bitgamma/gradusnik/(list of files, drawings)

Other design files:
gradusnik.dch
gradusnik.dip
