bitgamma/gradusnik/main.c

/*
 * Copyright (C) 2014, Michele Balistreri
 * 
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
 * THE SOFTWARE IS PROVIDED "AS IS", WITHOUT WARRANTY OF ANY KIND, EXPRESS OR
 * IMPLIED, INCLUDING BUT NOT LIMITED TO THE WARRANTIES OF MERCHANTABILITY,
 * FITNESS FOR A PARTICULAR PURPOSE AND NONINFRINGEMENT.  IN NO EVENT SHALL
 * THE AUTHORS OR COPYRIGHT HOLDERS BE LIABLE FOR ANY CLAIM, DAMAGES OR OTHER
 * LIABILITY, WHETHER IN AN ACTION OF CONTRACT, TORT OR OTHERWISE, ARISING
 * FROM, OUT OF OR IN CONNECTION WITH THE SOFTWARE OR THE USE OR OTHER
 * DEALINGS IN THE SOFTWARE.
 */

#include "config.h"
#include "MRF24J40.h"
#include "osnp.h"
#include "tlv.h"

#include <xc.h>
#include <stdlib.h>

static uint8_t rx_frame_buf[128];

static uint8_t wdt_en;
static uint8_t radio_sleep_en;
static int8_t timer_periods;
static int16_t calibration_offset;

bool transmitting;

#define CALIBRATION_OFFSET_ADDR 14
#define DEVICE_INFO_ADDR 72

__EEPROM_DATA(0x70, 0x3d, 0x62, 0x63, 0x96, 0x2c, 0x9b, 0xf2);
__EEPROM_DATA(0x00, 0x00, 0xff, 0xff, 0xff, 0xff, 0x00, 0x00);
__EEPROM_DATA(0x00, 0x01, 0x02, 0x03, 0x04, 0x05, 0x06, 0x07);
__EEPROM_DATA(0x08, 0x09, 0x0A, 0x0B, 0x0C, 0x0D, 0x0E, 0x0F);
__EEPROM_DATA(0x00, 0x00, 0x00, 0x00, 0x00, 0x00, 0x00, 0x00);
__EEPROM_DATA(0x00, 0x00, 0x00, 0x00, 0x00, 0x00, 0x00, 0x00);
__EEPROM_DATA(0x00, 0x00, 0x00, 0x00, 0x00, 0x00, 0x00, 0x00);
__EEPROM_DATA(0x00, 0x00, 0x00, 0x00, 0x00, 0x00, 0x00, 0x00);
__EEPROM_DATA(0x00, 0x00, 0x00, 0x00, 0x00, 0x00, 0x00, 0x00);
__EEPROM_DATA(0x28, 0xA0, 0x26, 0x81, 0x02, 0x00, 0x01, 0x82);
__EEPROM_DATA(0x01, 0xA2, 0xC0, 0x09, 'G', 'r', 'a', 'd');
__EEPROM_DATA('u', 's', 'n', 'i', 'k', 0xC1, 0x12, 'M');
__EEPROM_DATA('i', 'c', 'h', 'e', 'l', 'e', ' ', 'B');
__EEPROM_DATA('a', 'l', 'i', 's', 't', 'r', 'e', 'r');
__EEPROM_DATA('i', 0xff, 0xff, 0xff, 0xff, 0xff, 0xff, 0xff);

#define load_calibration_offset(buf) load_eeprom(buf, CALIBRATION_OFFSET_ADDR, 2)
#define write_calibration_offset(buf) write_eeprom(buf, CALIBRATION_OFFSET_ADDR, 2)

void load_eeprom(uint8_t *buf, uint16_t addr, uint16_t len) {
  EECON1bits.CFGS = 0;
  EECON1bits.EEPGD = 0;

  for (uint16_t i = 0; i < len; i++) {
    EEADR = addr++;
	EECON1bits.RD = 1;
    buf[i] = EEDATA;
  }
}

void write_eeprom(uint8_t *buf, uint16_t addr, uint16_t len) {
  INTCONbits.GIE = 0;
  EECON1bits.EEPGD = 0;
  EECON1bits.CFGS = 0;

  for (uint16_t i = 0; i < len; i++) {
	EEADR = addr++;
	EEDATA = buf[i];
	EECON1bits.WREN = 1;
    EECON2 = 0x55;
    EECON2 = 0xAA;
	EECON1bits.WR = 1;
	while(EECON1bits.WR);
	EECON1bits.WREN = 0;
  }

  INTCONbits.GIE = 1;
}

uint8_t spi_read() {
  uint8_t tmp;
  tmp = SSP1BUF;
  PIR1bits.SSP1IF = 0;
  SSP1BUF = 0x00;
  while(!PIR1bits.SSP1IF);
  return SSP1BUF;
}

void spi_write(uint8_t data) {
  uint8_t tmp;
  tmp = SSP1BUF;
  PIR1bits.SSP1IF = 0;
  SSP1BUF = data;
  while( !PIR1bits.SSP1IF );
}

void enable_wdt(uint8_t periods, bool radio_can_sleep) {
  wdt_en = true;
  radio_sleep_en = radio_can_sleep;
  timer_periods = periods;
}

void disable_wdt(void) {
  wdt_en = false;
  radio_sleep_en = false;
}

uint16_t process_get_device_info(uint8_t *buf) {
  uint8_t addr = DEVICE_INFO_ADDR;

  EEADR = addr++;
  EECON1 = 0x01;
  uint16_t len = EEDATA;

  load_eeprom(buf, addr, len);

  return len;
}

void write_temperature(uint8_t *buf) {
  LATAbits.LA0 = 1;
  VREFCON0 = 0x90;
  ADCON0bits.ADON = 1;

  __delay_ms(1);

  ADCON0bits.GO = 1;
  while(ADCON0bits.GO);
  
  uint16_t adc = (((uint16_t) ADRESH) << 8) | (ADRESL);

  if (adc >= 1023) {
    VREFCON0 = 0xA0;
    ADCON0bits.GO = 1;
    while(ADCON0bits.GO);
    adc = (((uint16_t) ADRESH) << 8) | (ADRESL);
    adc = (adc << 1);
  }

  LATAbits.LA0 = 0;
  ADCON0bits.ADON = 0;
  VREFCON0 = 0;

  // 500mV is our 0 point
  adc -= 500;
  adc += calibration_offset;
  
  *buf++ = ((uint16_t) adc) >> 8;
  *buf++ = adc & 0xff;
};

uint16_t process_get_data(uint8_t *buf) {
  *buf++ = 0xA2;
  *buf++ = 0x0C;
  *buf++ = 0xA1;
  *buf++ = 0x0A;
  *buf++ = 0x80;
  *buf++ = 0x01;
  *buf++ = 0x01;
  *buf++ = 0x81;
  *buf++ = 0x01;
  *buf++ = 0x0A;
  *buf++ = 0x82;
  *buf++ = 0x02;
  write_temperature(buf);
  buf += 2;

  return 14;
}

uint16_t process_configure(uint8_t *in_buf) {
  //TODO: crude, but should work
  if (in_buf[3] == 0x82) {
    calibration_offset = (in_buf[4] << 8) | in_buf[5];
    write_calibration_offset((uint8_t *)&calibration_offset);
  }

  return 0;
}

void write_error(uint8_t tag, uint8_t err, ieee802_15_4_frame_t *resp_frame, uint16_t *resp_off) {
  *resp_off += tlv_write_tag(&resp_frame->payload[*resp_off], tag);
  *resp_off += tlv_write_length(&resp_frame->payload[*resp_off], 3);
  *resp_off += tlv_write_tag(&resp_frame->payload[*resp_off], 0x9E);
  *resp_off += tlv_write_length(&resp_frame->payload[*resp_off], 1);
  resp_frame->payload[*resp_off++] = err;
}

void process_command(ieee802_15_4_frame_t *frame, uint16_t *in_off, ieee802_15_4_frame_t *resp_frame, uint16_t *resp_off, uint8_t associated) {
  uint16_t tag;
  uint16_t len;

  *in_off += tlv_read_tag(&frame->payload[*in_off], &tag);
  *in_off += tlv_read_length(&frame->payload[*in_off], &len);
  *in_off += len;

  switch(tag) {
    case OSNP_GET_DEVICE_INFO:
      *resp_off += process_get_device_info(&resp_frame->payload[*resp_off]);
      break;
    case OSNP_GET_DATA:
      if (!associated) {
        write_error(tag, OSNP_SECURITY_ERROR, resp_frame, resp_off);
      } else {
        *resp_off += process_get_data(&resp_frame->payload[*resp_off]);
      }
      break;
    case OSNP_CONFIGURE:
      if (!associated) {
        write_error(tag, OSNP_SECURITY_ERROR, resp_frame, resp_off);
      } else {
        process_configure(&frame->payload[*in_off]);
      }
      break;
    default:
      write_error(tag, OSNP_UNSUPPORTED_COMMAND, resp_frame, resp_off);
      break;
  }
}

void interrupt isr(void) {
  if (INTCON3bits.INT1F) {
    INTCON3bits.INT1F = 0;
    int interrupts = mrf24j40_int_tasks();
    
    if (interrupts & MRF24J40_INT_RX) {
      if (!mrf24j40_rx_sec_fail()) {
        osnp_frame_received_cb(rx_frame_buf, mrf24j40_rxpkt_intcb(rx_frame_buf, NULL, NULL));
      } else {
        mrf24j40_rxfifo_flush();
      }
    }

    if (interrupts & MRF24J40_INT_TX) {
      transmitting = false;
      osnp_frame_sent_cb(mrf24j40_txpkt_intcb());
    }

    if (interrupts & MRF24J40_INT_SEC) {
      mrf24j40_sec_intcb(true);
    }
  }
}

void main(void) {
  OSCCON2bits.MFIOSEL = 1;
  OSCCONbits.IRCF = 0x02;
  
  INTCONbits.GIE = 0;
  RCONbits.IPEN = 0;
  INTCON3bits.INT1E = 1;
  INTCON2bits.INTEDG1 = 0;
  
  TRISA = 0x20;
  TRISB = 0x02;
  TRISC = 0x10;

  LATA = 0;
  LATB = 0;
  LATC = 0;

  WPUB = 0;
  
  ADCON0 = 0x10;
  ADCON1 = 0x08;
  ADCON2 = 0xAF;

  ANSELA = 0x20;
  ANSELB = 0x00;
  ANSELC = 0x00;

  SSP1STATbits.CKE = 1;
  SSP1CON1 = 0x20;

  load_calibration_offset((uint8_t *)&calibration_offset);
  mrf24j40_initialize();
  mrf24j40_set_cipher(OSNP_SECURITY_LEVEL, OSNP_SECURITY_LEVEL);
  osnp_initialize();
  
  INTCON3bits.INT1F = 0;
  INTCONbits.GIE = 1;

  while(1) {
    uint16_t tx_timeout = 500;
    while(transmitting && tx_timeout) {
      __delay_ms(1);
      tx_timeout--;
    }

    // the transceiver skipped an interrupt
    if (transmitting) {
      transmitting = false;
      mrf24j40_read_short_ctrl_reg(INTSTAT);
      osnp_frame_sent_cb(mrf24j40_txpkt_intcb());
    }

    if (radio_sleep_en) {
      INTCONbits.GIE = 0;
      mrf24j40_sleep();
    }

    if (wdt_en) {
      WDTCONbits.SWDTEN = 1;
    }

    SLEEP();
    WDTCONbits.SWDTEN = 0;

    if (!RCONbits.TO) {
      timer_periods--;

      if (timer_periods <= 0) {
        wdt_en = false;

        if (radio_sleep_en) {
          radio_sleep_en = false;
          mrf24j40_wakeup();
          mrf24j40_rxfifo_flush();
          INTCONbits.GIE = 1;
        }
        
        osnp_timer_expired_cb();
      }
    }
  }
}
