bitgamma/gradusnik/config.h

/*
 * Copyright (C) 2014, Michele Balistreri
 *
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
 * THE SOFTWARE IS PROVIDED "AS IS", WITHOUT WARRANTY OF ANY KIND, EXPRESS OR
 * IMPLIED, INCLUDING BUT NOT LIMITED TO THE WARRANTIES OF MERCHANTABILITY,
 * FITNESS FOR A PARTICULAR PURPOSE AND NONINFRINGEMENT.  IN NO EVENT SHALL
 * THE AUTHORS OR COPYRIGHT HOLDERS BE LIABLE FOR ANY CLAIM, DAMAGES OR OTHER
 * LIABILITY, WHETHER IN AN ACTION OF CONTRACT, TORT OR OTHERWISE, ARISING
 * FROM, OUT OF OR IN CONNECTION WITH THE SOFTWARE OR THE USE OR OTHER
 * DEALINGS IN THE SOFTWARE.
 */

#ifndef CONFIG_H
#define	CONFIG_H

// PIC18F14K50 Configuration Bit Settings
#define _XTAL_FREQ 500000


// PIC18F26K22 Configuration Bit Settings

// CONFIG1H
#pragma config FOSC = INTIO67   // Oscillator Selection bits (Internal oscillator block)
#pragma config PLLCFG = OFF     // 4X PLL Enable (Oscillator used directly)
#pragma config PRICLKEN = ON    // Primary clock enable bit (Primary clock enabled)
#pragma config FCMEN = OFF      // Fail-Safe Clock Monitor Enable bit (Fail-Safe Clock Monitor disabled)
#pragma config IESO = OFF       // Internal/External Oscillator Switchover bit (Oscillator Switchover mode disabled)

// CONFIG2L
#pragma config PWRTEN = OFF     // Power-up Timer Enable bit (Power up timer disabled)
#pragma config BOREN = OFF      // Brown-out Reset Enable bits (Brown-out Reset disabled in hardware and software)
#pragma config BORV = 190       // Brown Out Reset Voltage bits (VBOR set to 1.90 V nominal)

// CONFIG2H
#pragma config WDTEN = SWON     // Watchdog Timer Enable bits (WDT is controlled by SWDTEN bit of the WDTCON register)
#pragma config WDTPS = 256      // Watchdog Timer Postscale Select bits (1:256)

// CONFIG3H
#pragma config CCP2MX = PORTB3  // CCP2 MUX bit (CCP2 input/output is multiplexed with RB3)
#pragma config PBADEN = OFF     // PORTB A/D Enable bit (PORTB<5:0> pins are configured as digital I/O on Reset)
#pragma config CCP3MX = PORTB5  // P3A/CCP3 Mux bit (P3A/CCP3 input/output is multiplexed with RB5)
#pragma config HFOFST = ON      // HFINTOSC Fast Start-up (HFINTOSC output and ready status are not delayed by the oscillator stable status)
#pragma config T3CMX = PORTB5   // Timer3 Clock input mux bit (T3CKI is on RB5)
#pragma config P2BMX = PORTB5   // ECCP2 B output mux bit (P2B is on RB5)
#pragma config MCLRE = EXTMCLR  // MCLR Pin Enable bit (MCLR pin enabled, RE3 input pin disabled)

// CONFIG4L
#pragma config STVREN = ON      // Stack Full/Underflow Reset Enable bit (Stack full/underflow will cause Reset)
#pragma config LVP = ON         // Single-Supply ICSP Enable bit (Single-Supply ICSP enabled if MCLRE is also 1)
#pragma config XINST = OFF      // Extended Instruction Set Enable bit (Instruction set extension and Indexed Addressing mode disabled (Legacy mode))

// CONFIG5L
#pragma config CP0 = OFF        // Code Protection Block 0 (Block 0 (000800-003FFFh) not code-protected)
#pragma config CP1 = OFF        // Code Protection Block 1 (Block 1 (004000-007FFFh) not code-protected)
#pragma config CP2 = OFF        // Code Protection Block 2 (Block 2 (008000-00BFFFh) not code-protected)
#pragma config CP3 = OFF        // Code Protection Block 3 (Block 3 (00C000-00FFFFh) not code-protected)

// CONFIG5H
#pragma config CPB = OFF        // Boot Block Code Protection bit (Boot block (000000-0007FFh) not code-protected)
#pragma config CPD = OFF        // Data EEPROM Code Protection bit (Data EEPROM not code-protected)

// CONFIG6L
#pragma config WRT0 = OFF       // Write Protection Block 0 (Block 0 (000800-003FFFh) not write-protected)
#pragma config WRT1 = OFF       // Write Protection Block 1 (Block 1 (004000-007FFFh) not write-protected)
#pragma config WRT2 = OFF       // Write Protection Block 2 (Block 2 (008000-00BFFFh) not write-protected)
#pragma config WRT3 = OFF       // Write Protection Block 3 (Block 3 (00C000-00FFFFh) not write-protected)

// CONFIG6H
#pragma config WRTC = OFF       // Configuration Register Write Protection bit (Configuration registers (300000-3000FFh) not write-protected)
#pragma config WRTB = OFF       // Boot Block Write Protection bit (Boot Block (000000-0007FFh) not write-protected)
#pragma config WRTD = OFF       // Data EEPROM Write Protection bit (Data EEPROM not write-protected)

// CONFIG7L
#pragma config EBTR0 = OFF      // Table Read Protection Block 0 (Block 0 (000800-003FFFh) not protected from table reads executed in other blocks)
#pragma config EBTR1 = OFF      // Table Read Protection Block 1 (Block 1 (004000-007FFFh) not protected from table reads executed in other blocks)
#pragma config EBTR2 = OFF      // Table Read Protection Block 2 (Block 2 (008000-00BFFFh) not protected from table reads executed in other blocks)
#pragma config EBTR3 = OFF      // Table Read Protection Block 3 (Block 3 (00C000-00FFFFh) not protected from table reads executed in other blocks)

// CONFIG7H
#pragma config EBTRB = OFF      // Boot Block Table Read Protection bit (Boot Block (000000-0007FFh) not protected from table reads executed in other blocks)


// Includes
#include <xc.h>
#include <stdint.h>
#include <stdbool.h>
#include "MRF24J40.h"
#include "osnp.h"

// Definitions
#define OSNP_FRAME_COUNTER_WINDOW 1000
#define OSNP_SECURITY_LEVEL SL_AES_CCM_64
#define OSNP_MIC_LENGTH 8
#define LITTLE_ENDIAN

#define EUI_64_ADDR 0
#define PAN_ID_ADDR 8
#define SHORT_ADDRESS_ADDR 10
#define CHANNEL_ADDR 12
#define MASTER_KEY 16
#define RX_AES_KEY 32
#define TX_AES_KEY 48
#define RX_FRAME_COUNTER 64
#define TX_FRAME_COUNTER 68

// MRF24J40 HAL Configuration
#define mrf24j40_set_ie(v) (INTCON3bits.INT1E = v)
#define mrf24j40_get_ie() (INTCON3bits.INT1E)

#define mrf24j40_reset_pin(v) (PORTCbits.RC0 = v)
#define mrf24j40_wake_pin(v) (PORTCbits.RC1 = v)
#define mrf24j40_cs_pin(v) (PORTCbits.RC2 = v)

#define mrf24j40_spi_read() spi_read()
#define mrf24j40_spi_write(val) spi_write(val)
#define mrf24j40_delay_us(v) __delay_us(v)
#define mrf24j40_delay_ms(v) __delay_ms(v)

// OSNP HAL Configuration
#define osnp_load_eui(buf) load_eeprom(buf, EUI_64_ADDR, 8); mrf24j40_set_eui(buf)
#define osnp_load_pan_id(buf) load_eeprom(buf, PAN_ID_ADDR, 2); mrf24j40_set_pan(buf)
#define osnp_load_short_address(buf) load_eeprom(buf, SHORT_ADDRESS_ADDR, 2); mrf24j40_set_short_addr(buf)
#define osnp_load_channel(ch) load_eeprom(ch, CHANNEL_ADDR, 1)
#define osnp_load_master_key(buf) load_eeprom(buf, MASTER_KEY, 16); mrf24j40_rx_key(buf)
#define osnp_load_rx_key(buf) load_eeprom(buf, RX_AES_KEY, 16); mrf24j40_rx_key(buf)
#define osnp_load_tx_key(buf) load_eeprom(buf, TX_AES_KEY, 16); mrf24j40_tx_key(buf)
#define osnp_load_rx_frame_counter(frame_counter) load_eeprom(frame_counter, RX_FRAME_COUNTER, 4)
#define osnp_load_tx_frame_counter(frame_counter) load_eeprom(frame_counter, TX_FRAME_COUNTER, 4)

#define osnp_write_pan_id(buf) write_eeprom(buf, PAN_ID_ADDR, 2); mrf24j40_set_pan(buf)
#define osnp_write_short_address(buf) write_eeprom(buf, SHORT_ADDRESS_ADDR, 2); mrf24j40_set_short_addr(buf)
#define osnp_write_channel(ch) write_eeprom(ch, CHANNEL_ADDR, 1)
#define osnp_write_rx_key(buf) write_eeprom(buf, RX_AES_KEY, 16); mrf24j40_rx_key(buf)
#define osnp_write_tx_key(buf) write_eeprom(buf, TX_AES_KEY, 16); mrf24j40_tx_key(buf)
#define osnp_write_rx_frame_counter(frame_counter) write_eeprom(frame_counter, RX_FRAME_COUNTER, 4)
#define osnp_write_tx_frame_counter(frame_counter) write_eeprom(frame_counter, TX_FRAME_COUNTER, 4)

#define osnp_process_command(frame, in_off, resp_frame, resp_off, associated) process_command(frame, in_off, resp_frame, resp_off, associated)
#define osnp_build_notification(frame, notification_offset)
#define osnp_switch_channel(ch) mrf24j40_set_channel(ch)
#define osnp_transmit_frame(frame)  transmitting = true; mrf24j40_txpkt((frame)->backing_buffer, (frame)->header_len, (frame)->sec_header_len, (frame)->payload_len)
#define osnp_get_pending_frames() mrf24j40_get_pending_frame()

#define osnp_start_channel_scanning_timer() enable_wdt(1, false)
#define osnp_start_association_wait_timer() enable_wdt(10, false)
#define osnp_start_poll_timer() enable_wdt(2, true)
#define osnp_start_pending_data_wait_timer() enable_wdt(1, false)
#define osnp_stop_active_timer() disable_wdt()

#define OSNP_DEVICE_CAPABILITES RX_POLL_DRIVEN

// Globals
extern bool transmitting;

// Function prototypes
uint8_t spi_read(void);
void spi_write(uint8_t data);
void load_eeprom(uint8_t *buf, uint16_t addr, uint16_t len);
void write_eeprom(uint8_t *buf, uint16_t addr, uint16_t len);
void enable_wdt(uint8_t periods, uint8_t radio_can_sleep);
void disable_wdt(void);
void process_command(ieee802_15_4_frame_t *frame, uint16_t *in_off, ieee802_15_4_frame_t *resp_frame, uint16_t *resp_off, uint8_t associated);
#endif	/* CONFIG_H */
