bitgamma/gradusnik/(commit log)

2014-05-08 handled case where tx int is generated between wdt and sleep
2014-05-08 handle negative timer periods
2014-05-08 avoid lock-up, increases risk of reset, but that's ok.
    [main.c]
2014-05-09 readded support for short addressing
    [config.h]
2014-05-15 added schematics
    [gradusnik.dch]
2014-05-15 updated schematics
    [gradusnik.dch]
2014-05-15 fixed mrf24j40ma component
    [gradusnik.dch]
2014-05-19 detect skipped transmission and resume work
    [main.c]
2014-06-08 changed power supply
    [gradusnik.dch, gradusnik.dip]
2014-06-08 migrated to DipTrace 2.4
    [gradusnik.dch, gradusnik.dip]
2014-06-16 use 0805 component for caps
    [gradusnik.dch, gradusnik.dip]
2014-07-17 switched to PIC18F2XK22 family for better resolution
    [gradusnik.dip]
2014-07-18 improved power consumption
2014-07-21 lowered power consumption
2014-07-26 adjusted paths
    [gradusnik.dch, gradusnik.dip]
